cyfinfaza/Arcjet-PPU/Arcjet-PPU Build/Arcjet-PPU-Schematic.pdf

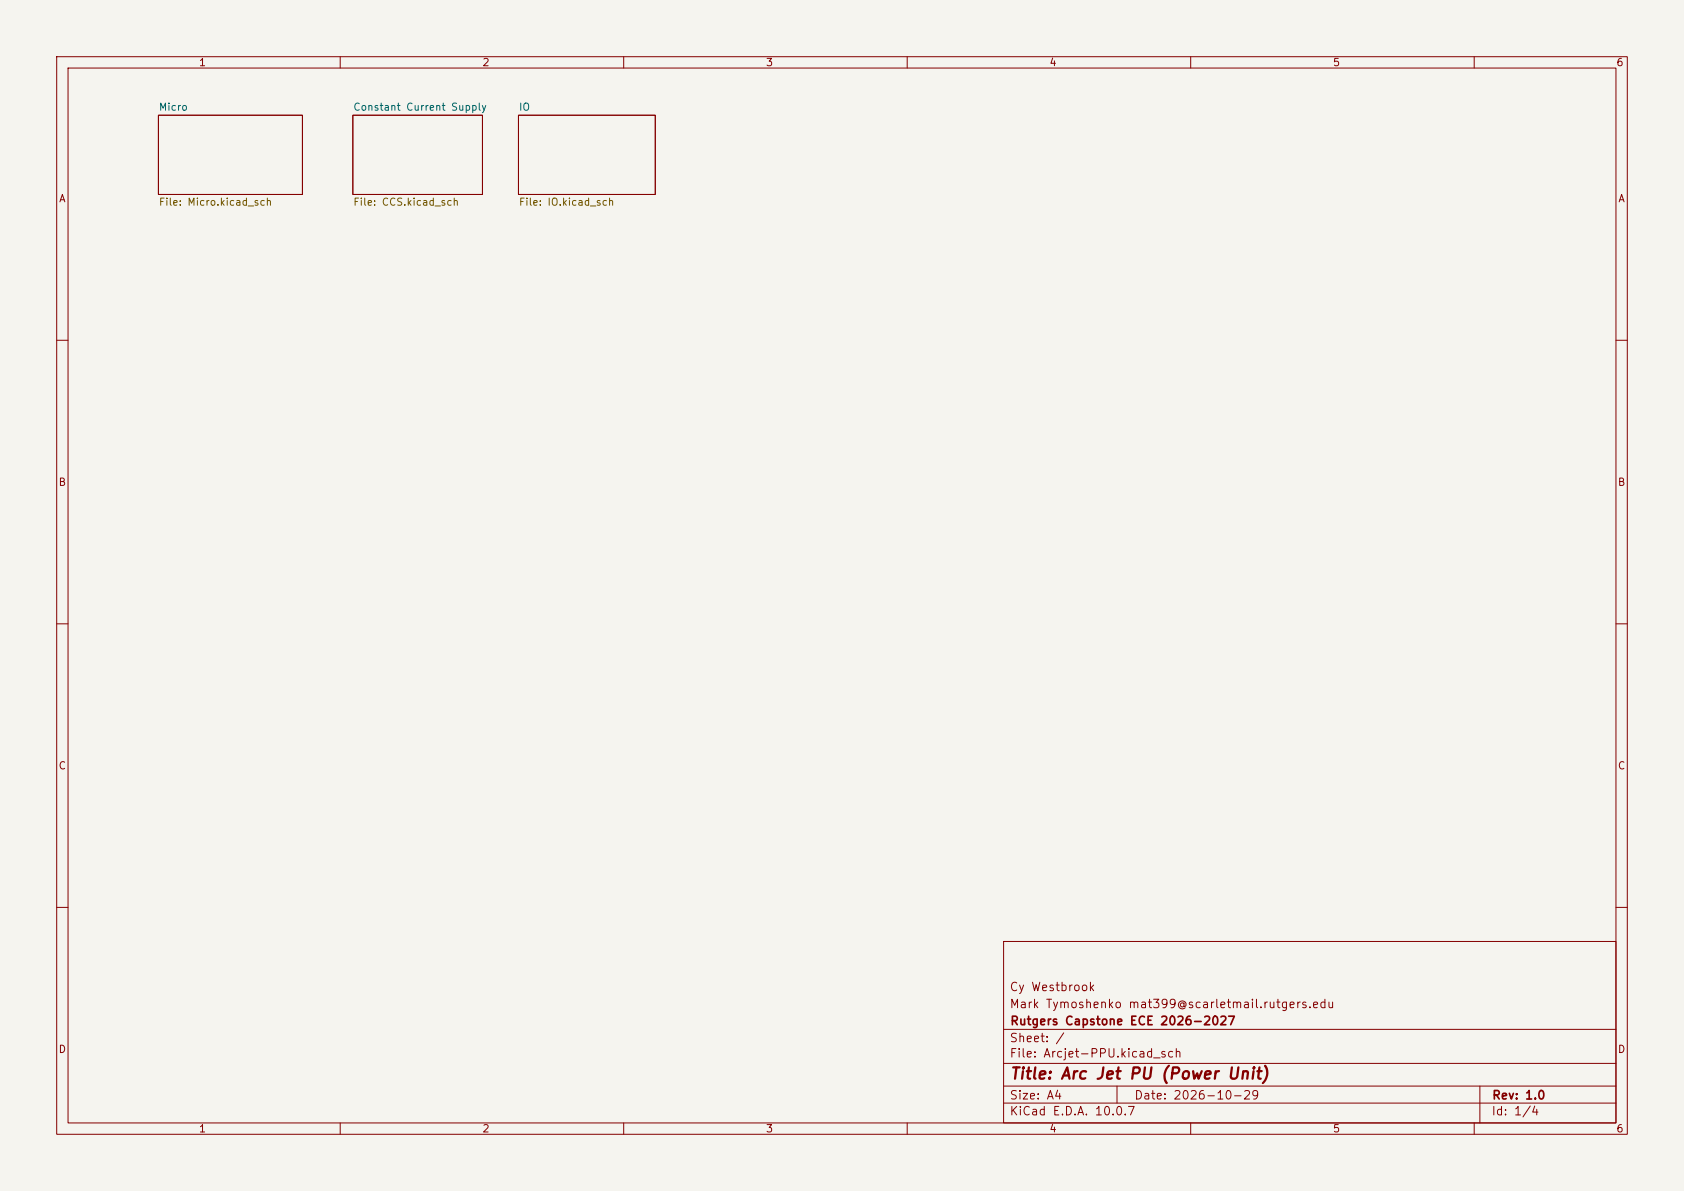
[picture p1: page 1]

File: IO.kicad_sch Constant Current Supply File: CCS.kicad_sch

Cy Westbrook
Mark Tymoshenko mat399@scarletmail.rutgers.edu
Rutgers Capstone ECE 2026-2027
Sheet: /
File: Arcjet-PPU.kicad_sch
Title: Arc Jet PU (Power Unit)

Size: A4 | Rev: 1.0
KiCad E.D.A. 10.0.7 | Id: 1/4

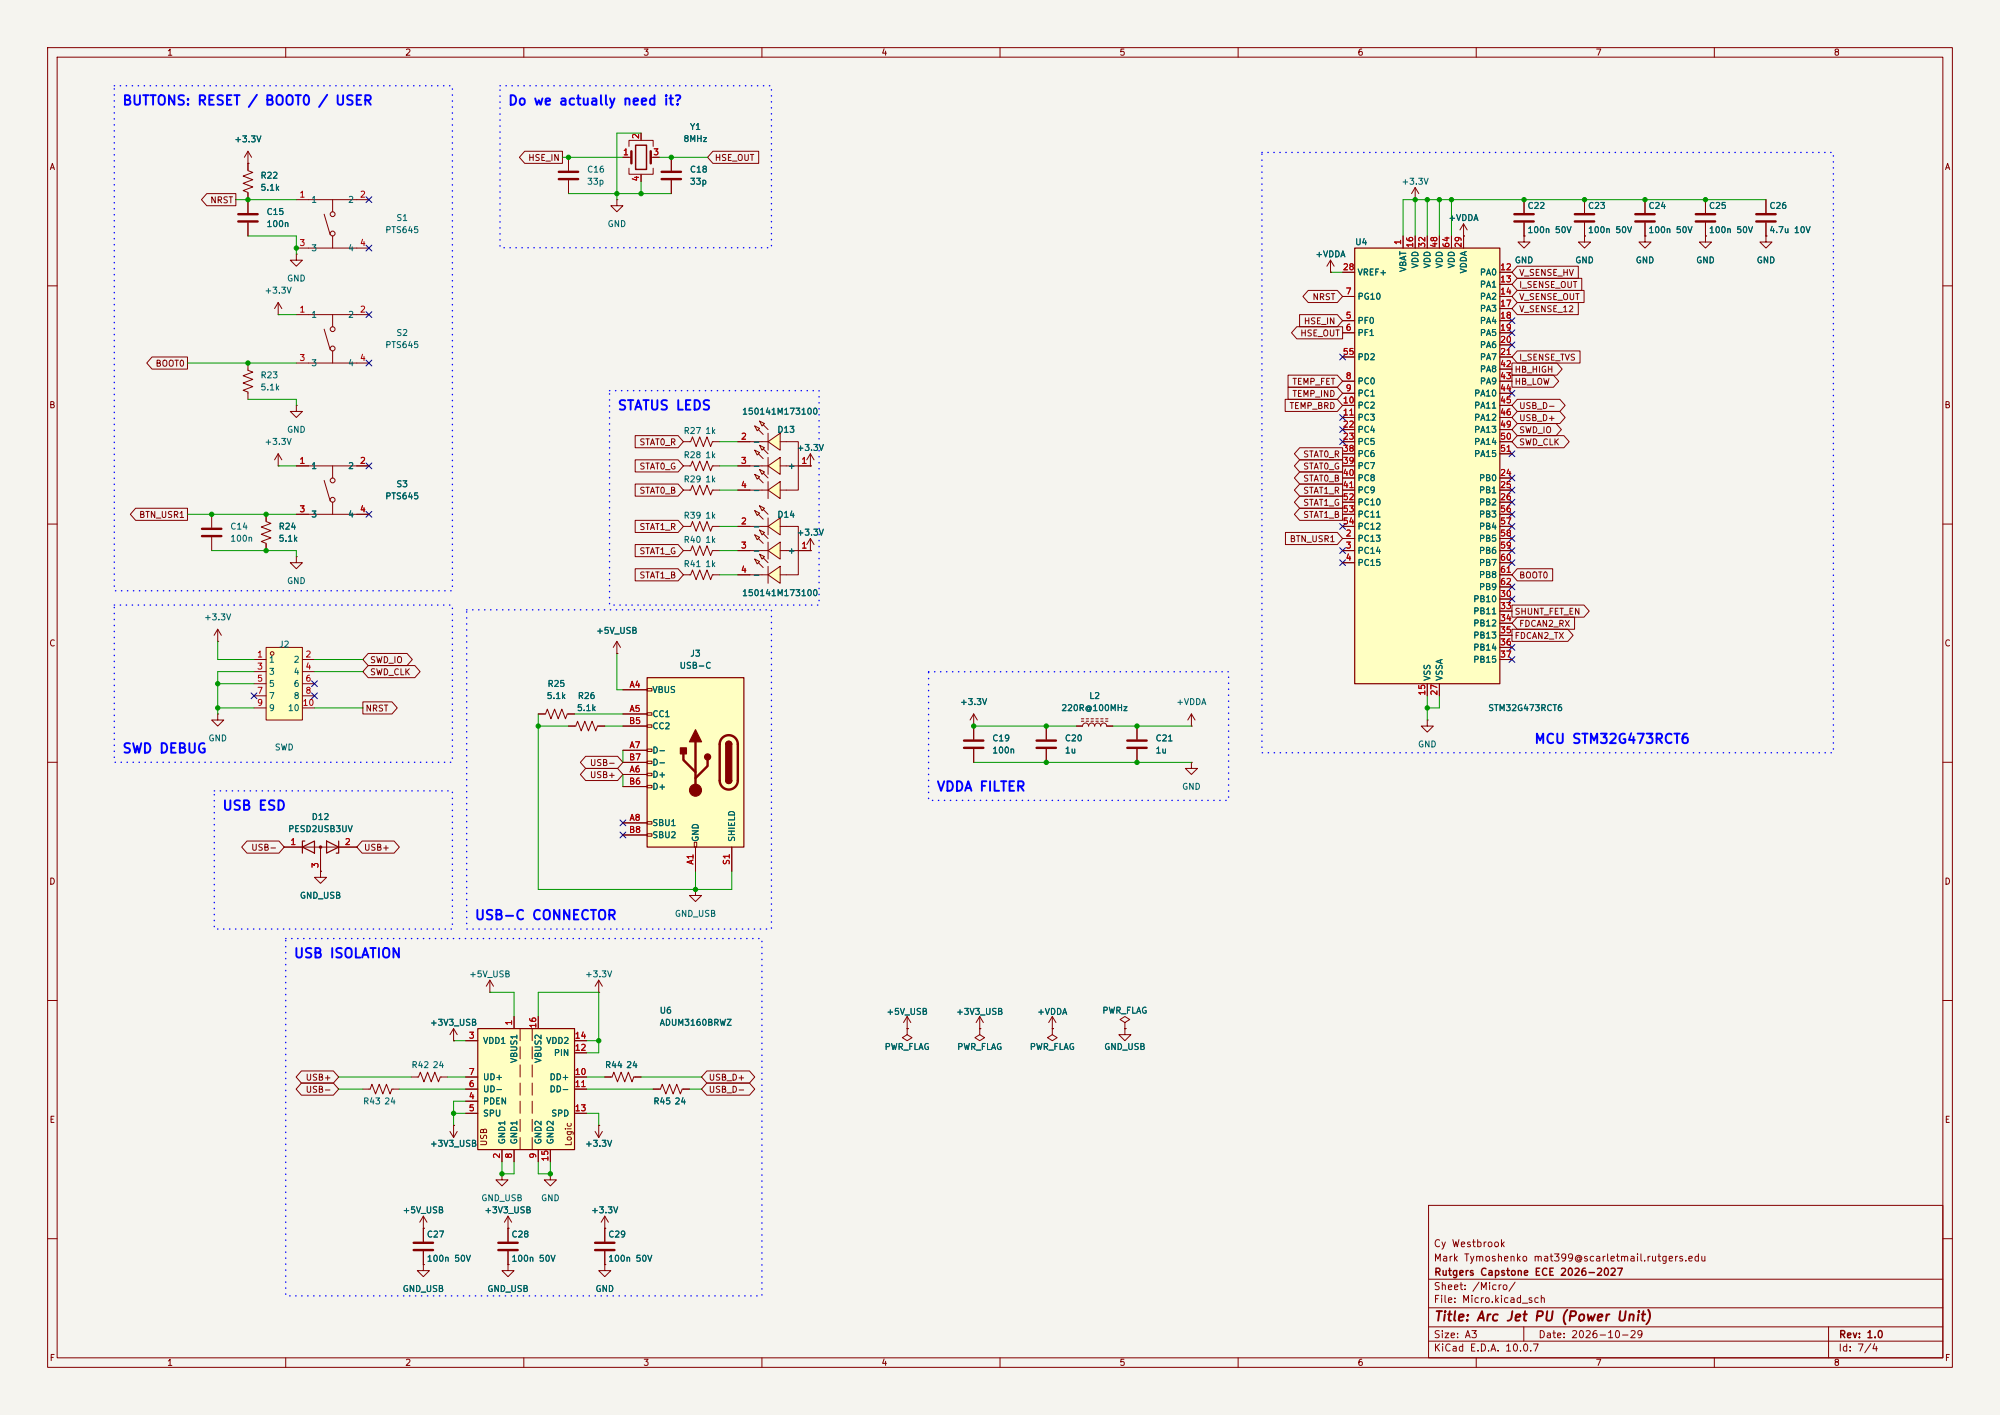
[picture p2: page 2]

USB- Do we actually need it?

STATUS LEDS 150141M173100 150141M173100 + 150141M173100

SWD DEBUG

Cy Westbrook
Mark Tymoshenko mat399@scarletmail.rutgers.edu
Rutgers Capstone ECE 2026-2027
Sheet: /Micro/
File: Micro.kicad_sch
Title: Arc Jet PU (Power Unit)

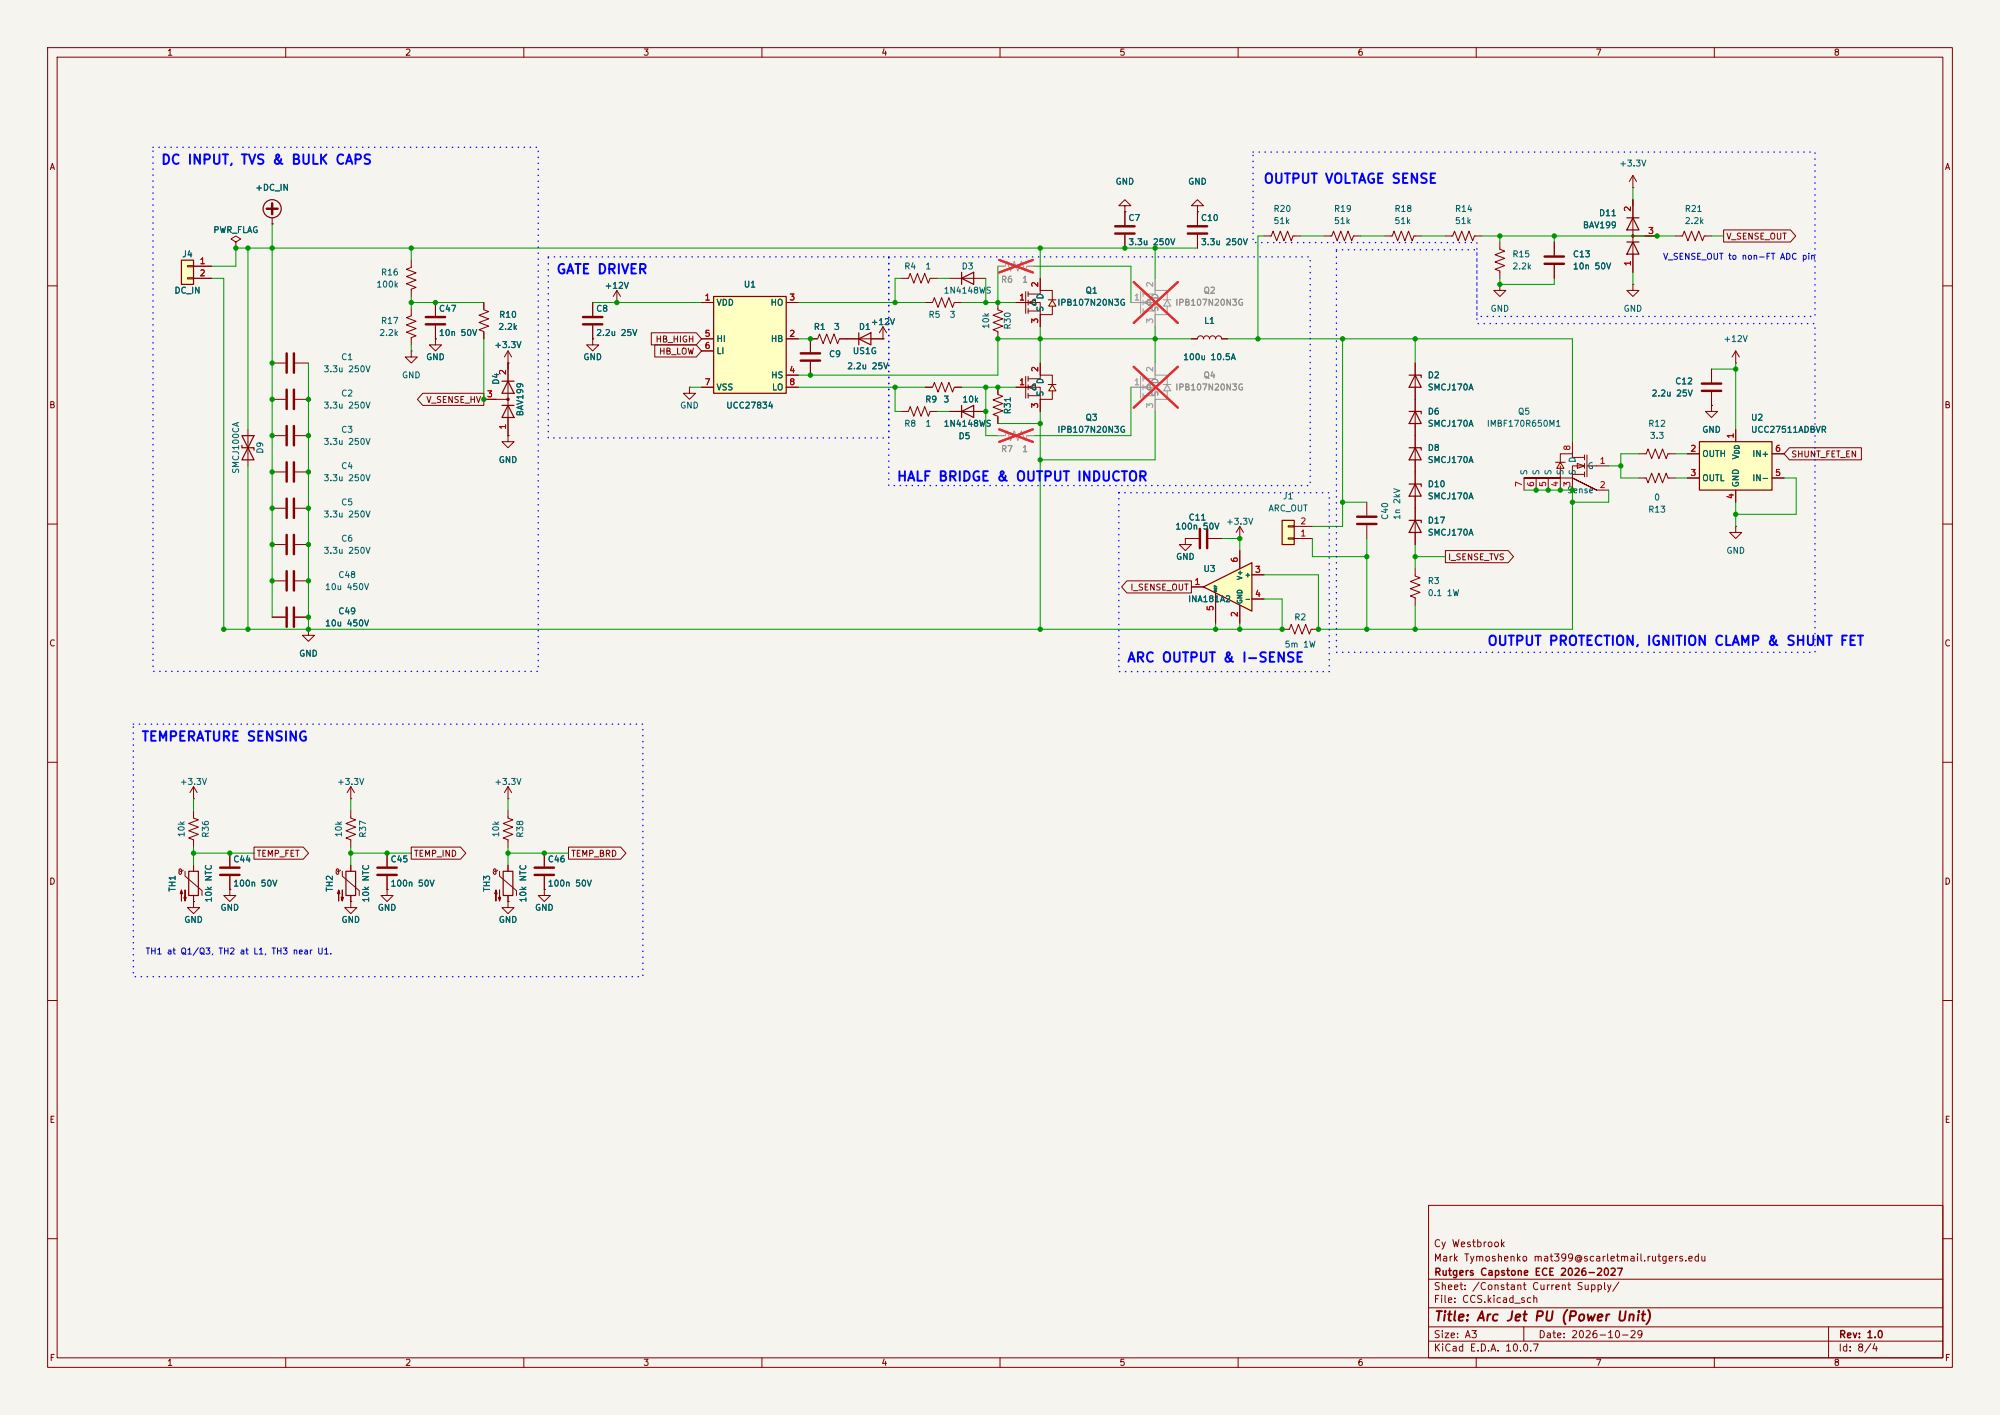
[picture p3: page 3]

DC INPUT, TVS & BULK CAPS

V_SENSE_OUT to non-FT ADC pin

OUTPUT PROTECTION, IGNITION CLAMP & SHUNT FET

Mark Tymoshenko mat399@scarletmail.rutgers.edu
Rutgers Capstone ECE 2026-2027
Sheet: /Constant Current Supply/
File: CCS.kicad_sch

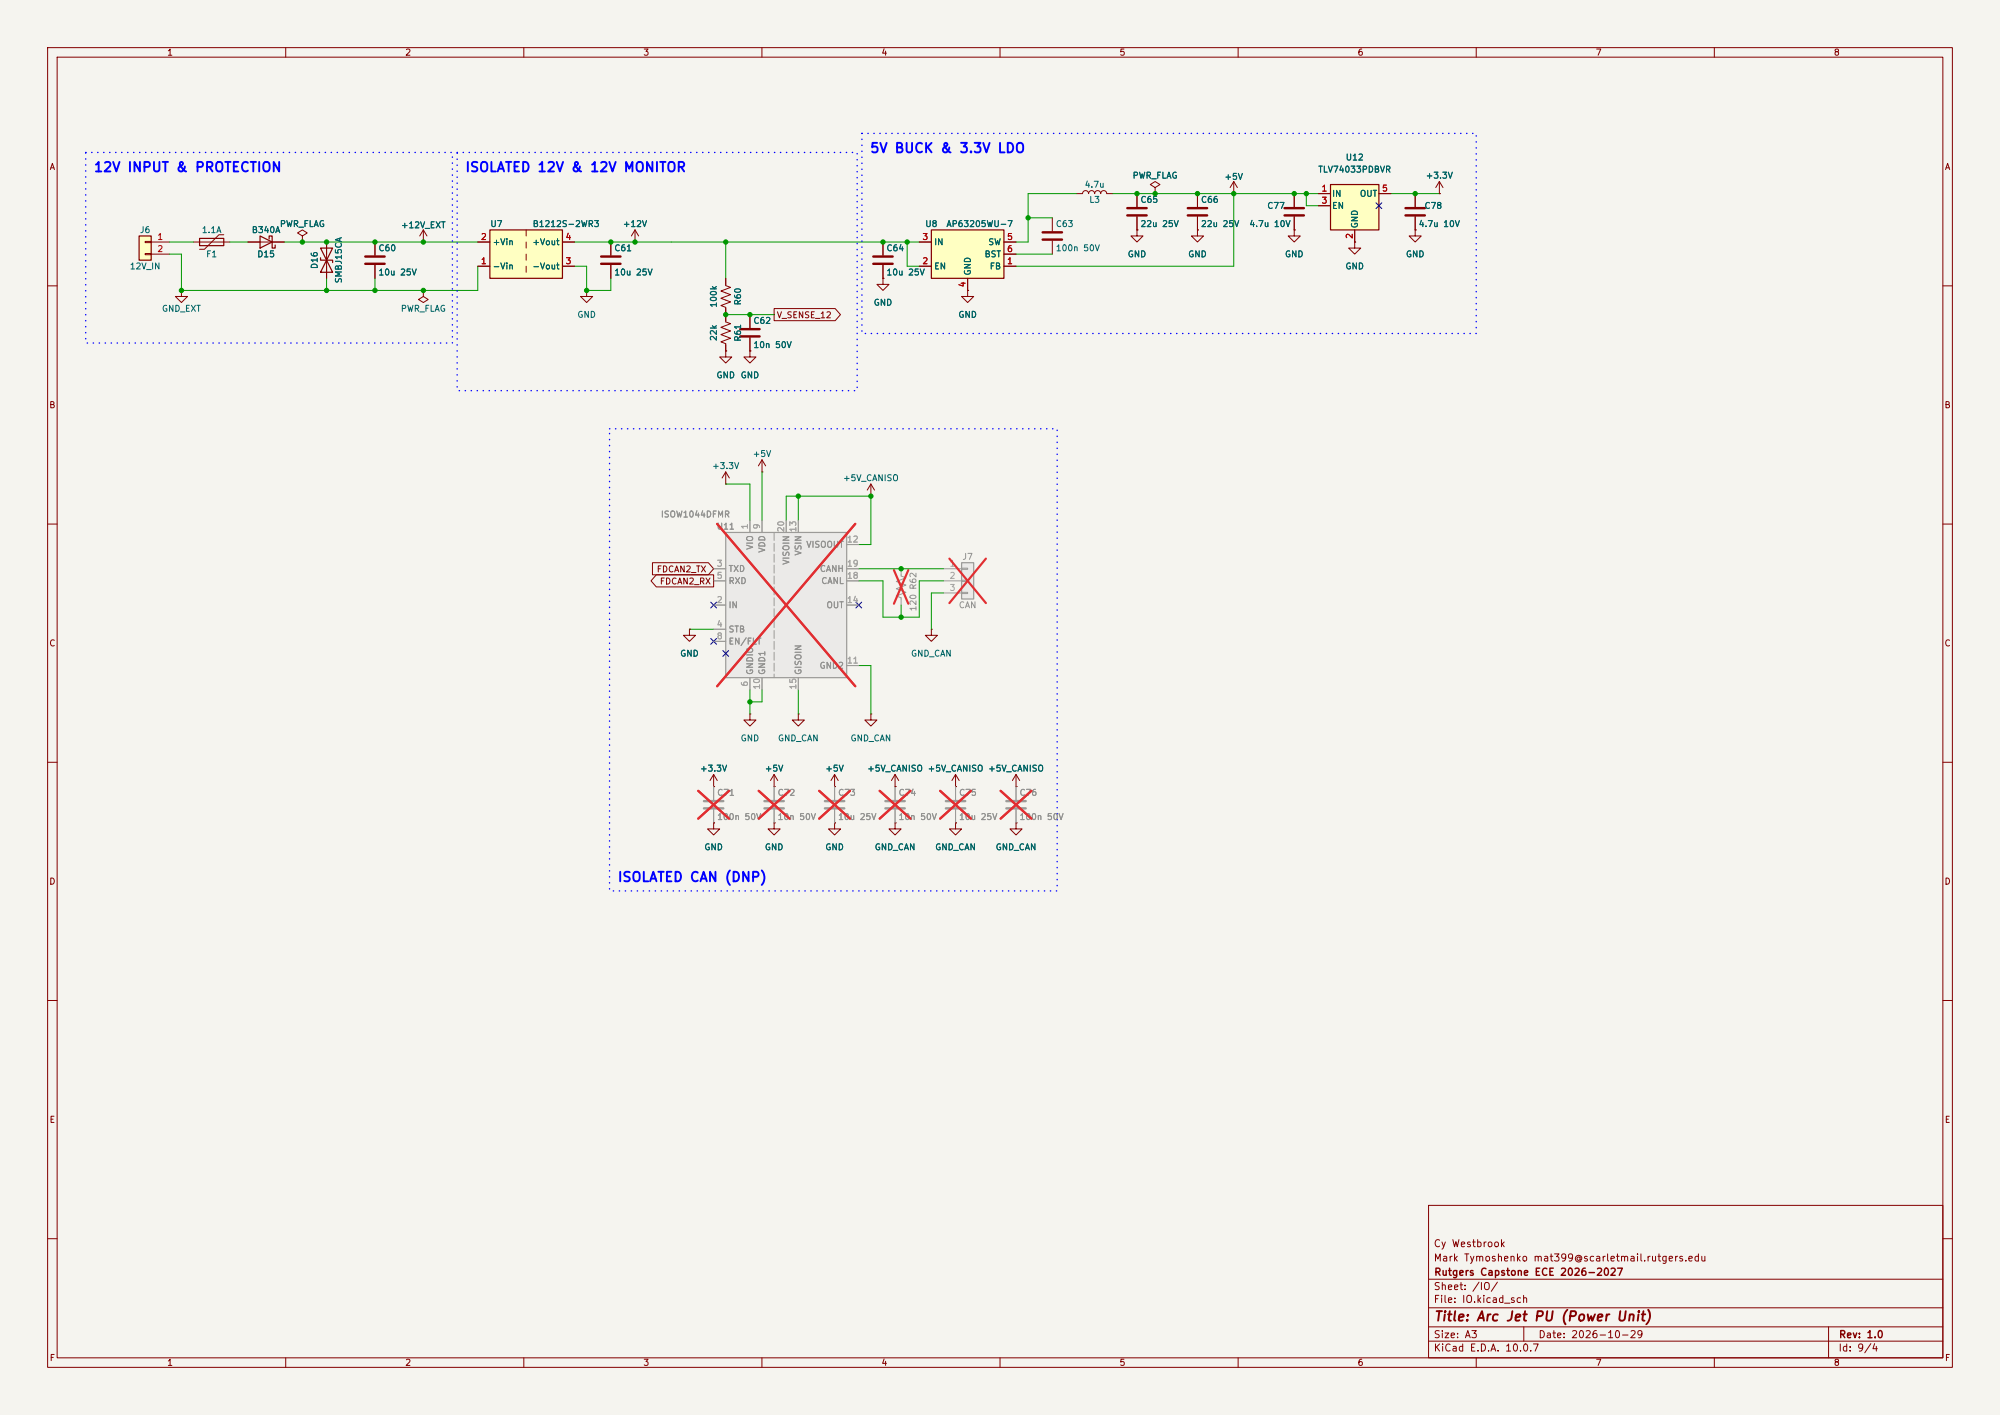
[picture p4: page 4]

Cy Westbrook
Mark Tymoshenko mat399@scarletmail.rutgers.edu
Rutgers Capstone ECE 2026-2027
Sheet: /IO/
File: IO.kicad_sch
