cyfinfaza/Arcjet-PPU/CCS.kicad_sch

## KiCad design CCS.kicad_sch (2026-11-02, an earlier design)

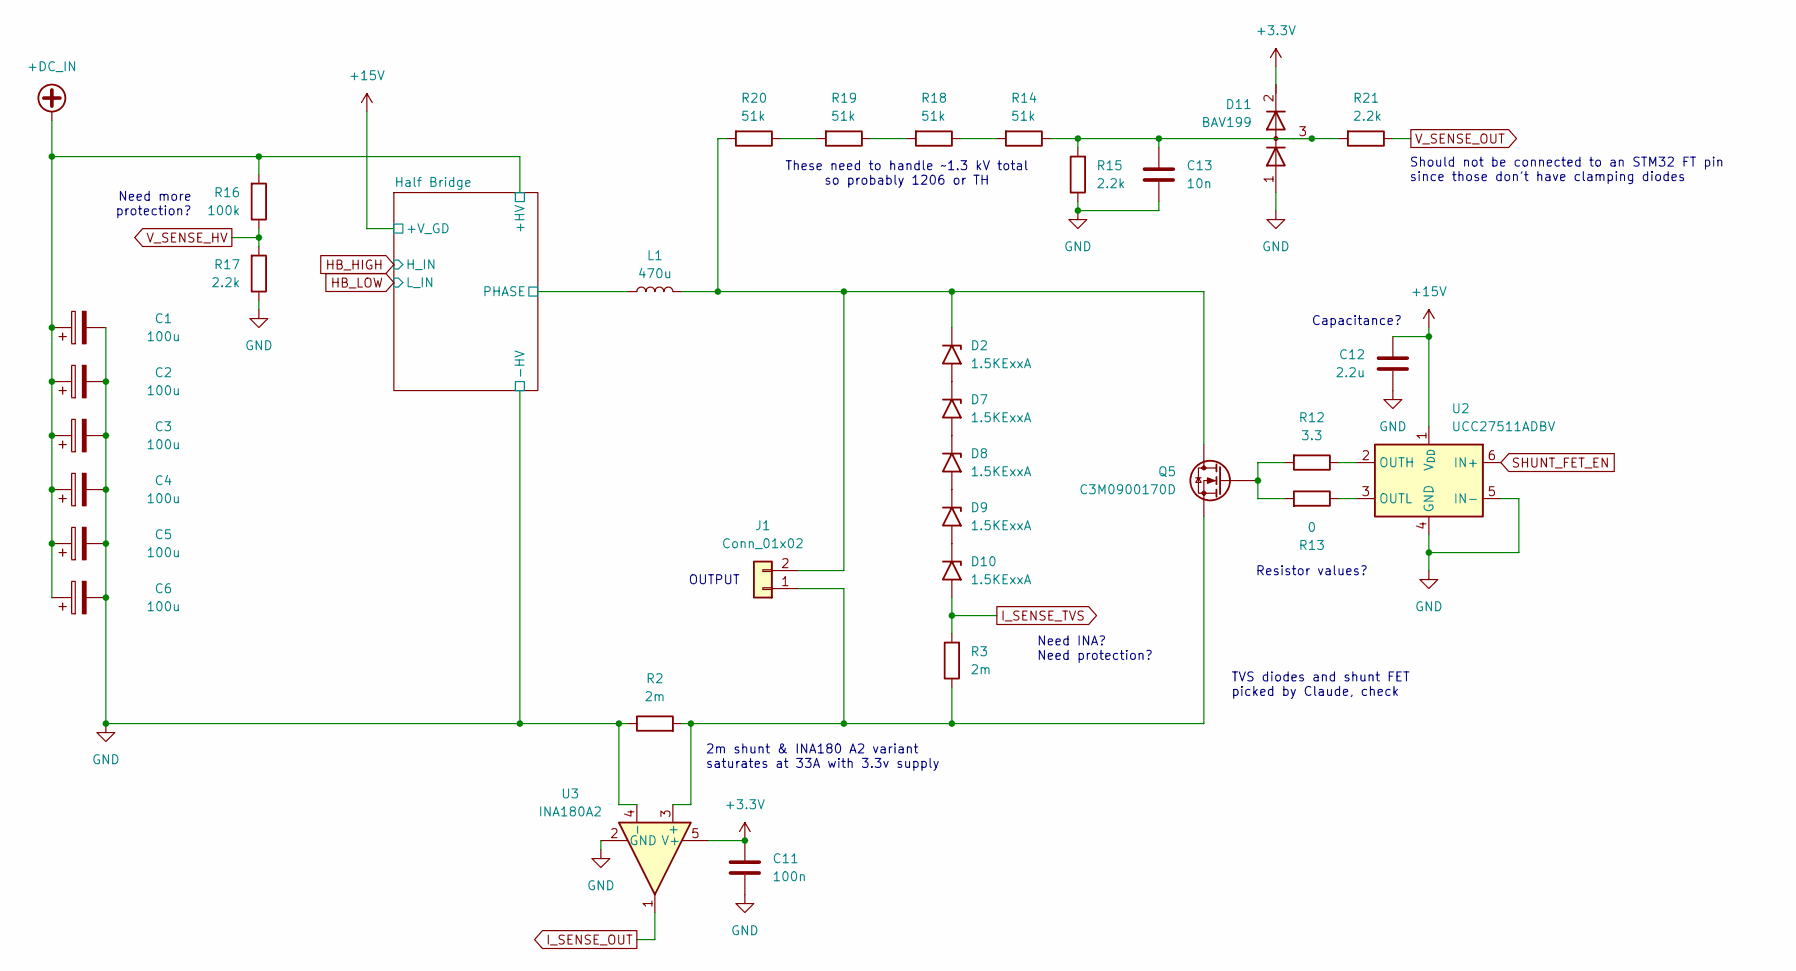
[picture p5: schematic CCS.kicad_sch]

Parts:
C1, C2, C3, C4, C5, C6: 100u
C11: 100n; C_0603_1608Metric_Pad1.08x0.95mm_HandSolder
C12: 2.2u; C_0603_1608Metric_Pad1.08x0.95mm_HandSolder
C13: 10n; C_0603_1608Metric_Pad1.08x0.95mm_HandSolder
D2, D7, D8, D9, D10: 1.5KExxA; D_DO-201AE_P15.24mm_Horizontal
D11: BAV199; SOT-23
J1: Conn_01x02
L1: 470u
Q5: C3M0900170D; TO-247-3_Vertical
R2, R3: 2m
R12: 3.3
R13: 0
R14, R18, R19, R20: 51k
R15, R17, R21: 2.2k
R16: 100k
U2: UCC27511ADBV; SOT-23-6
U3: INA180A2; SOT-23-5

Connections:
+3.3V: C11.1, D11.2 (K), U3.5 (V+)
+15V: C12.1, U2.1 (V_{DD})
+DC_IN: C1.1, C2.1, C3.1, C4.1, C5.1, C6.1, R16.2
GND: C1.2, C2.2, C3.2, C4.2, C5.2, C6.2, C11.2, C12.2, C13.2, D11.1 (A), R2.1, R15.1, R17.1, U2.4 (GND), U2.5 (IN-), U3.2 (GND), U3.4 (-)
I_SENSE_OUT: U3.1
I_SENSE_TVS: D10.2 (A2), R3.2
unnamed: C13.1, D11.3 (common), R14.1, R15.2, R21.2
unnamed: D2.1 (A1), J1.2, L1.2, Q5.D, R20.2
unnamed: D2.2 (A2), D7.1 (A1)
unnamed: D7.2 (A2), D8.1 (A1)
unnamed: D8.2 (A2), D9.1 (A1)
unnamed: D9.2 (A2), D10.1 (A1)
unnamed: J1.1, Q5.S, R2.2, R3.1, U3.3 (+)
unnamed: Q5.G, R12.2, R13.2
unnamed: R12.1, U2.2 (OUTH)
unnamed: R13.1, U2.3 (OUTL)
unnamed: R14.2, R18.1
unnamed: R18.2, R19.1
unnamed: R19.2, R20.1
PHASE: L1.1
SHUNT_FET_EN: U2.6 (IN+)
V_SENSE_HV: R16.1, R17.2
V_SENSE_OUT: R21.1

Notes on the sheet:
Need more protection?
Capacitance?
Need INA? Need protection?
Should not be connected to an STM32 FT pin since those don't have clamping diodes
These need to handle ~1.3 kV total so probably 1206 or TH
OUTPUT
TVS diodes and shunt FET picked by Claude, check
2m shunt & INA180 A2 variant saturates at 33A with 3.3v supply
Resistor values?
