cyfinfaza/Arcjet-PPU/Gate_Resistors.kicad_sch

## KiCad design Gate_Resistors.kicad_sch (2026-10-30)

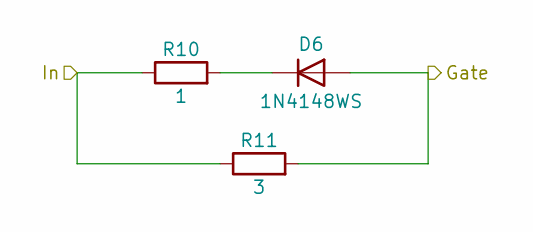
[picture p6: schematic Gate_Resistors.kicad_sch]

Parts:
D6: 1N4148WS; BiggerPads_D_SOD-323
R10: 1; R_0603_1608Metric_Pad0.98x0.95mm_HandSolder
R11: 3; R_0603_1608Metric_Pad0.98x0.95mm_HandSolder

Connections:
Gate: D6.2 (A), R11.2
In: R10.1, R11.1
unnamed: D6.1 (K), R10.2
