cyfinfaza/Arcjet-PPU/Half_Bridge.kicad_sch

## KiCad design Half_Bridge.kicad_sch (2026-10-30)

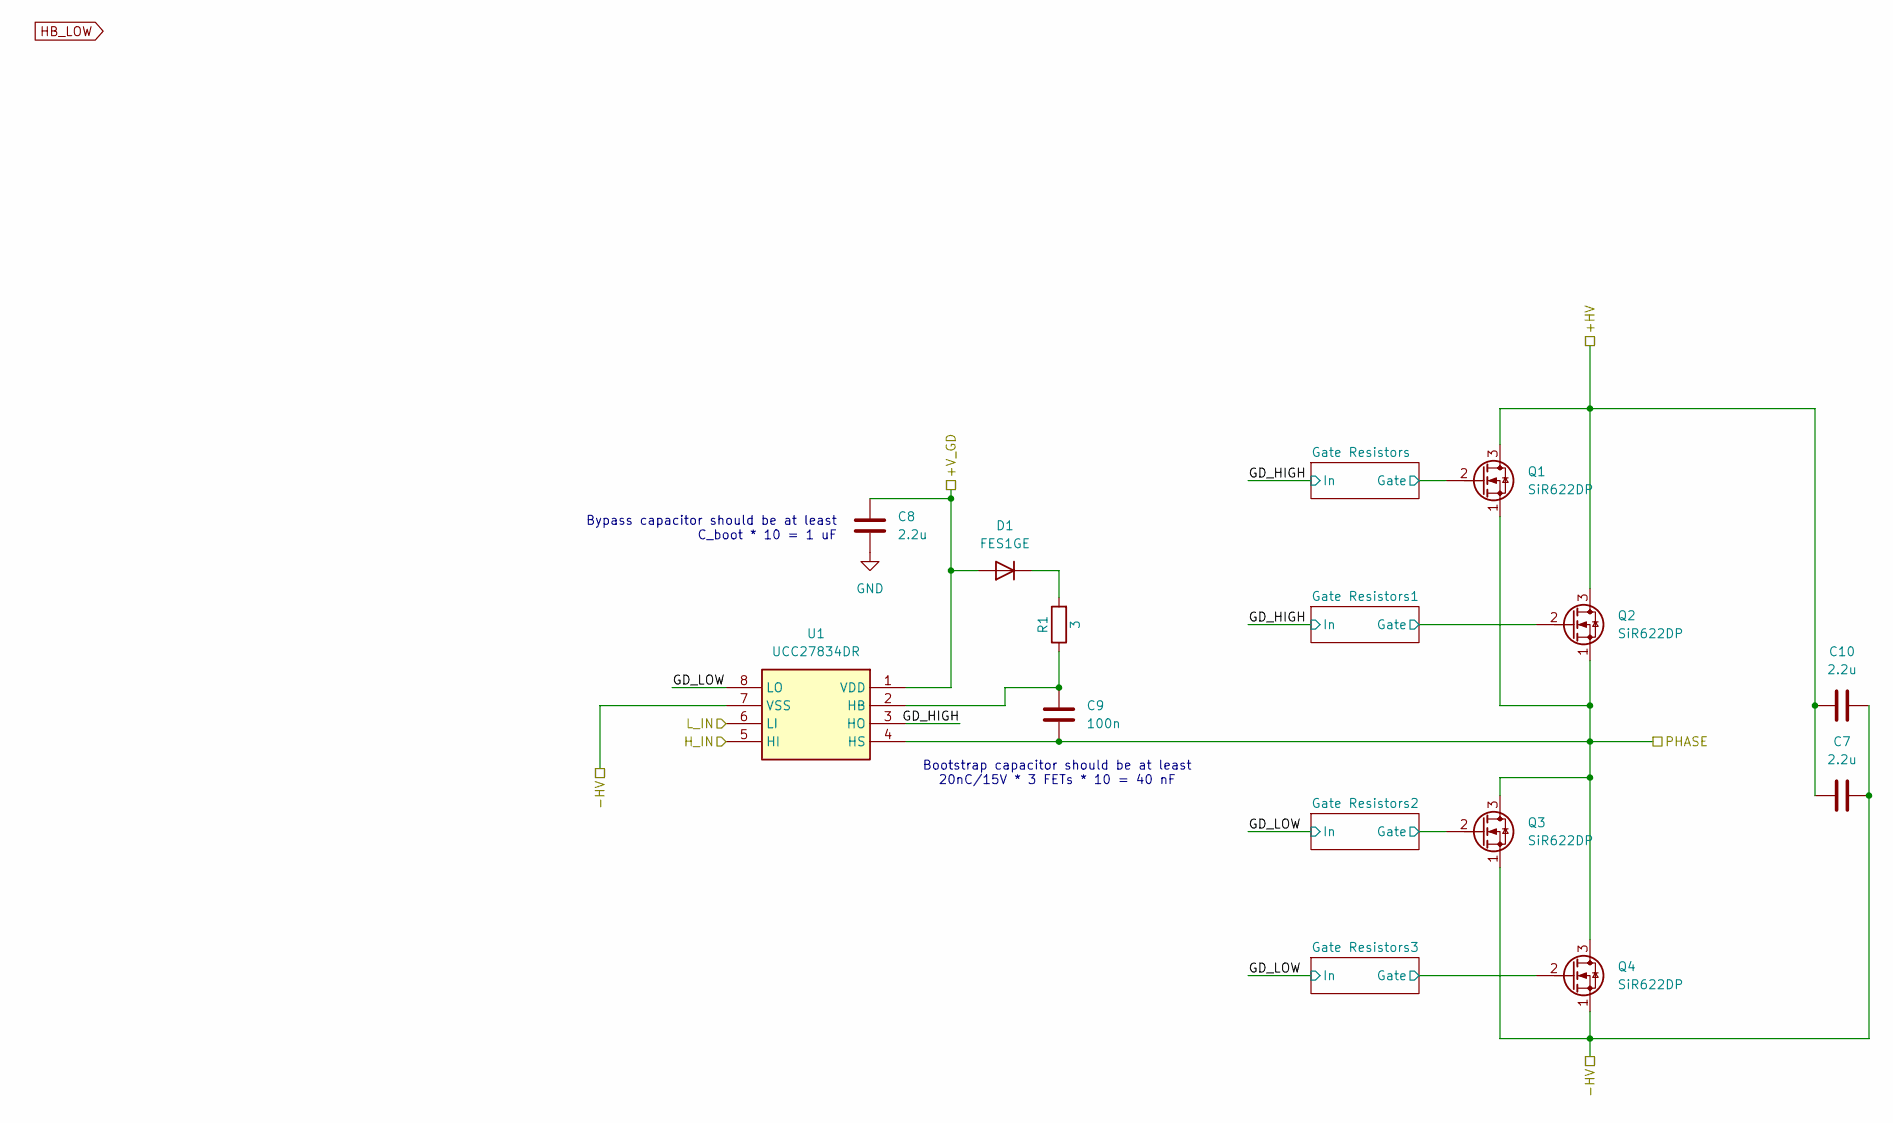
[picture p7: schematic Half_Bridge.kicad_sch]

Parts:
C7, C10: 2.2u; C_2220_5750Metric_Pad1.97x5.40mm_HandSolder
C8: 2.2u; C_0603_1608Metric_Pad1.08x0.95mm_HandSolder
C9: 100n; C_0603_1608Metric_Pad1.08x0.95mm_HandSolder
D1: FES1GE; D_SMF
Q1, Q2, Q3, Q4: SiR622DP; VSONP-8-1EP_5x6_P1.27mm
R1: 3; R_0603_1608Metric_Pad0.98x0.95mm_HandSolder
U1: UCC27834DR; SOIC127P600X175-8N; Manufacturer_Part_Number UCC27834DR

Connections:
+HV: C7.1, C10.1, Q1.3 (D), Q2.3 (D)
+V_GD: C8.1, D1.2 (A), U1.1 (VDD)
-HV: C7.2, C10.2, Q3.1 (S), Q4.1 (S), U1.7 (VSS)
GD_HIGH: U1.3 (HO)
GD_LOW: U1.8 (LO)
GND: C8.2
Gate: Q1.2 (G), Q2.2 (G), Q3.2 (G), Q4.2 (G)
H_IN: U1.5 (HI)
L_IN: U1.6 (LI)
unnamed: C9.1, R1.1, U1.2 (HB)
unnamed: D1.1 (K), R1.2
PHASE: C9.2, Q1.1 (S), Q2.1 (S), Q3.3 (D), Q4.3 (D), U1.4 (HS)

Notes on the sheet:
Bootstrap capacitor should be at least 20nC/15V * 3 FETs * 10 = 40 nF
Bypass capacitor should be at least C_boot * 10 = 1 uF
