cyfinfaza/Arcjet-PPU/(commit log)

2026-11-02 micro schematic and Constant done
2026-11-02 Addtional mosfet layouts, fixed ignition fet, and di7 fix
